kily-smith/Kily_Power/README.md

# Kily_PowerUnit
双向四开关同步整流Buck-Boost同步整流超级电容控制器

# 底部

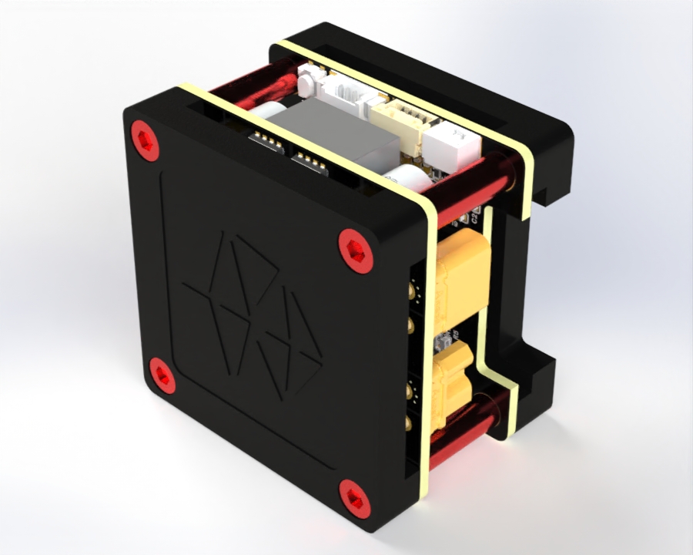
[picture p1: IMAGES/1.jpg]


# 顶部

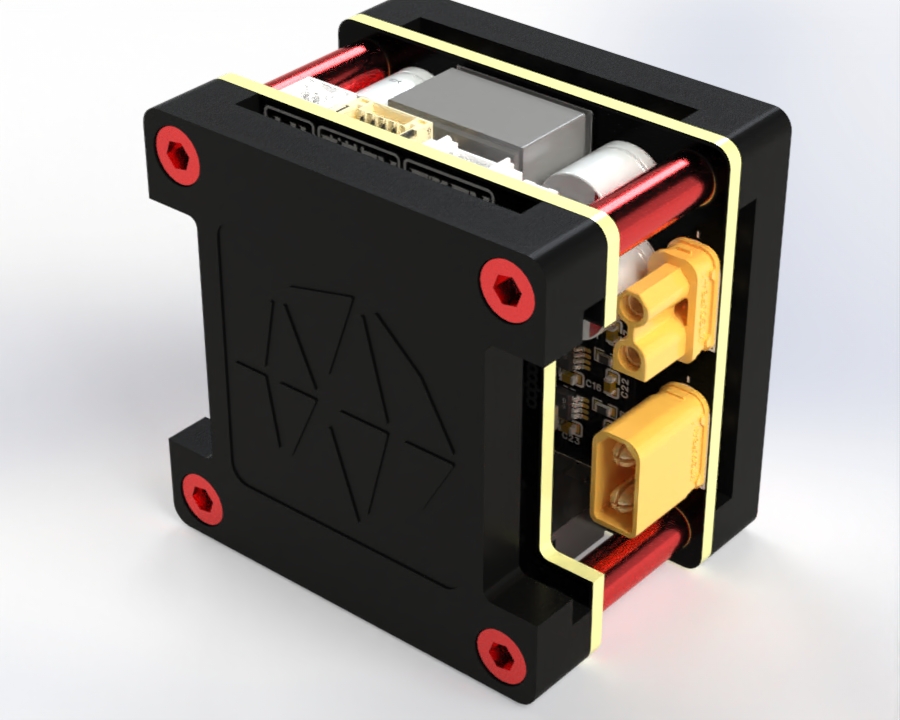
[picture p2: IMAGES/2.jpg]


# 功率板

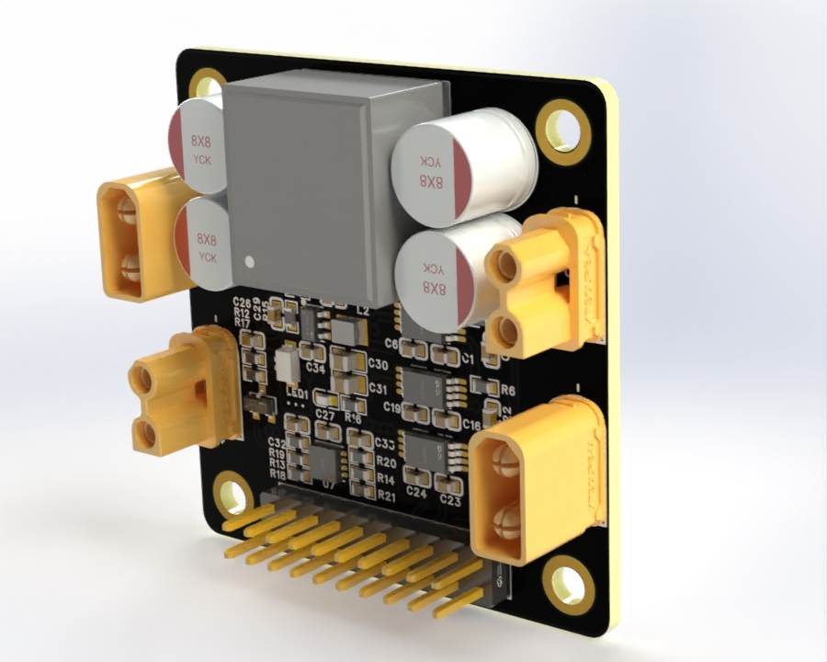
[picture p3: IMAGES/3.jpg]


注意：>>
