kily-smith/Kily_Power/3D_MODEL/3D_Kily_Contrl_45mm_V0.1_2025-03-08.png

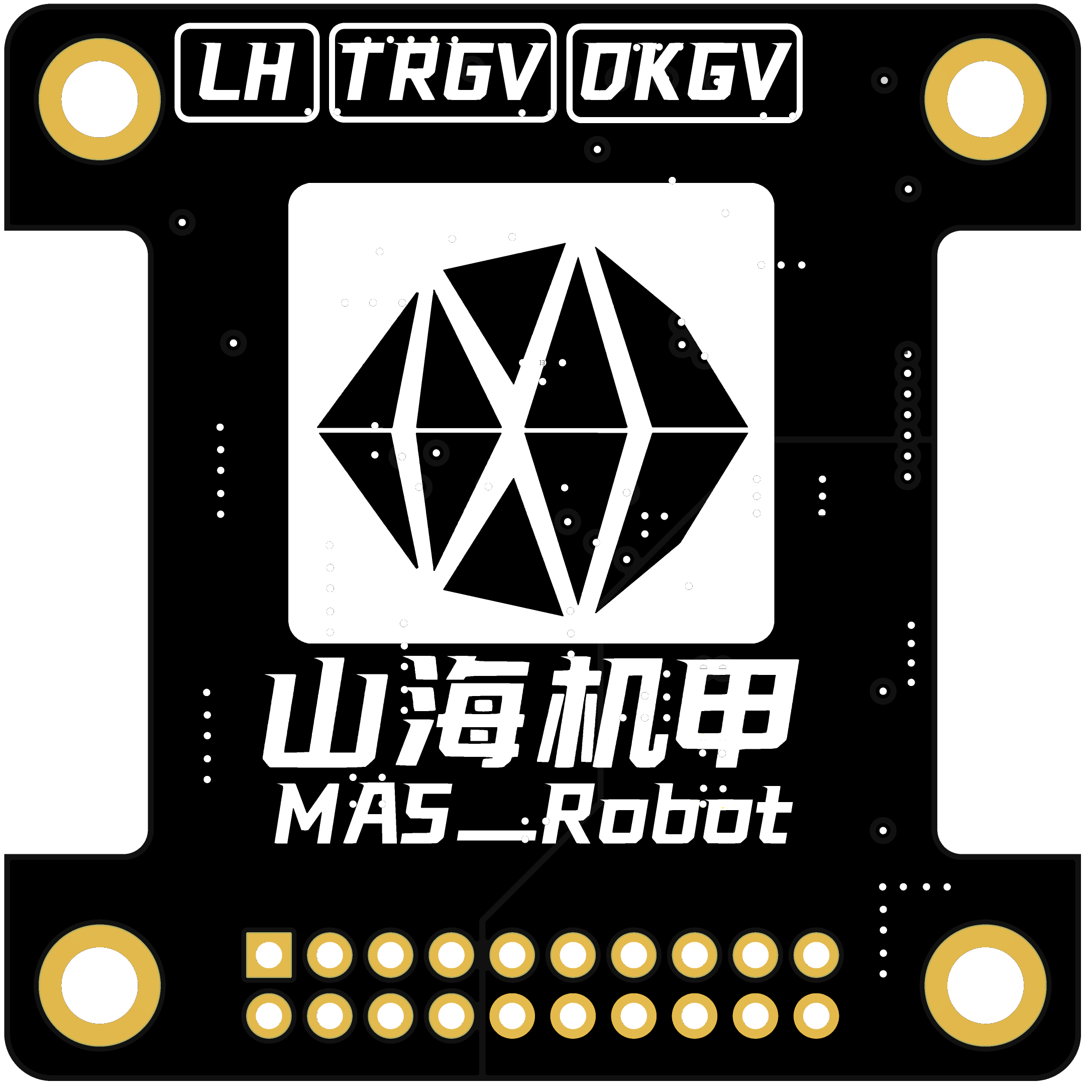
3D_MODEL/3D_Kily_Contrl_45mm_V0.1_2025-03-08.png
