kily-smith/Kily_Power/3D_MODEL/3D_Kily_Power_45mm_2025-03-08 (1).png

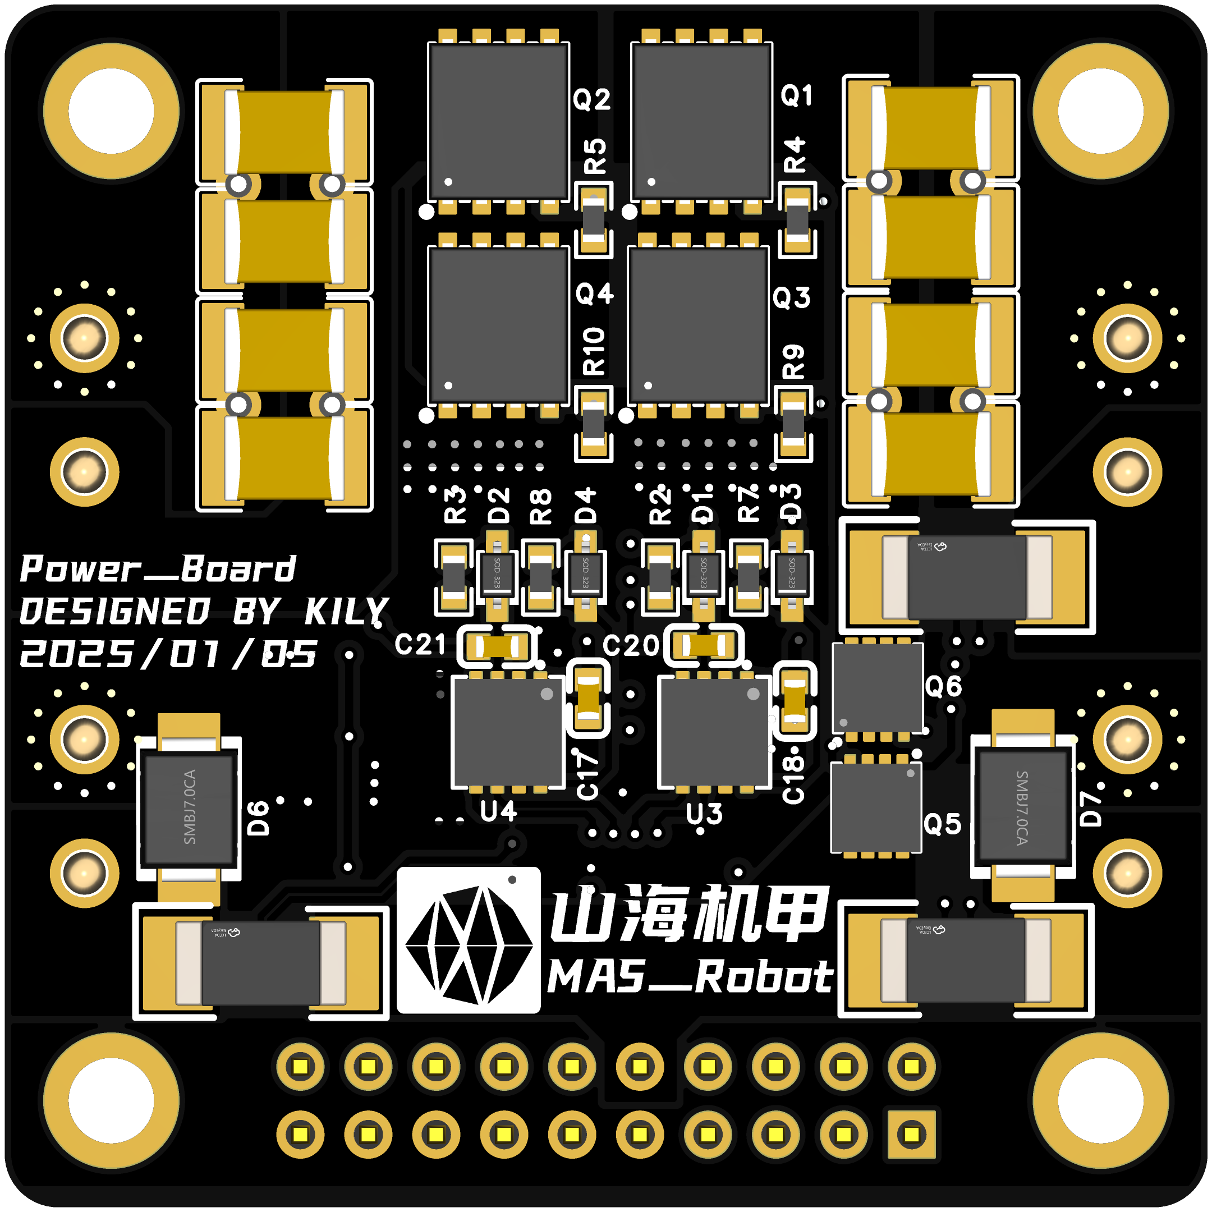
3D_MODEL/3D_Kily_Power_45mm_2025-03-08 (1).png
