kily-smith/Kily_Power/3D_MODEL/SuperCapUnit_MODEL/3D_PCB8_2_2025-03-09 (1).png

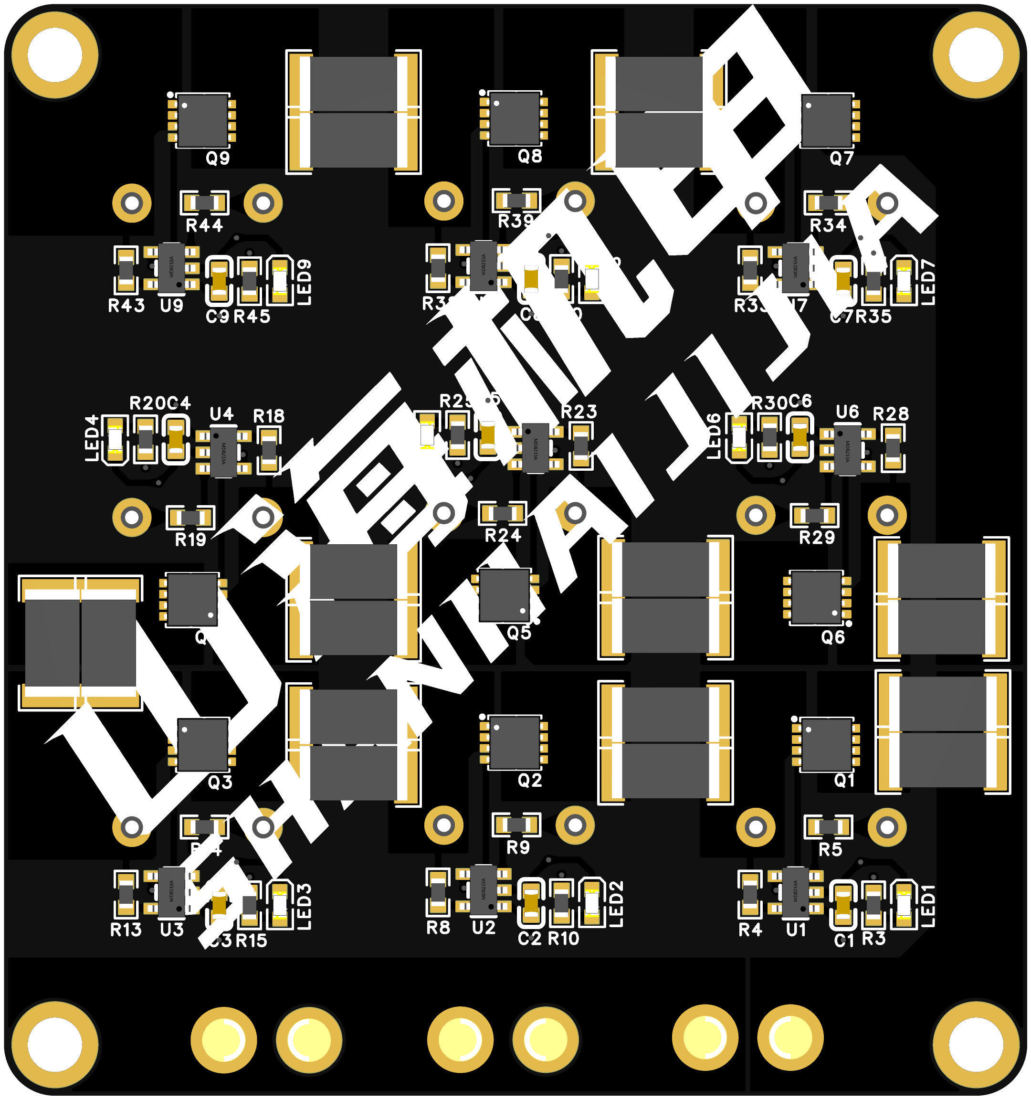
3D_MODEL/SuperCapUnit_MODEL/3D_PCB8_2_2025-03-09 (1).png
