kily-smith/Kily_Power/3D_MODEL/SuperCapUnit_MODEL/3D_PCB8_2_2025-03-09.png

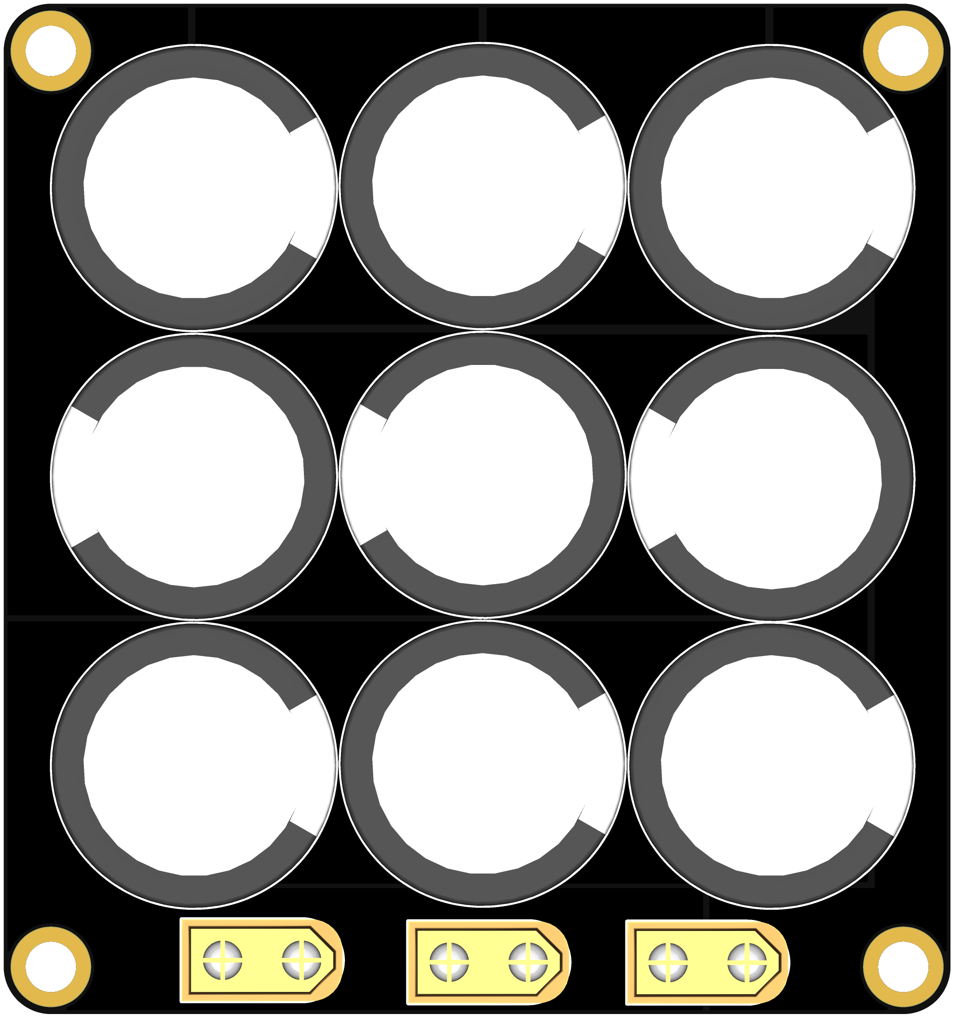
3D_MODEL/SuperCapUnit_MODEL/3D_PCB8_2_2025-03-09.png
