kily-smith/Kily_Power/IMAGES/3D_Kily_Contrl_45mm_2025-02-06.png

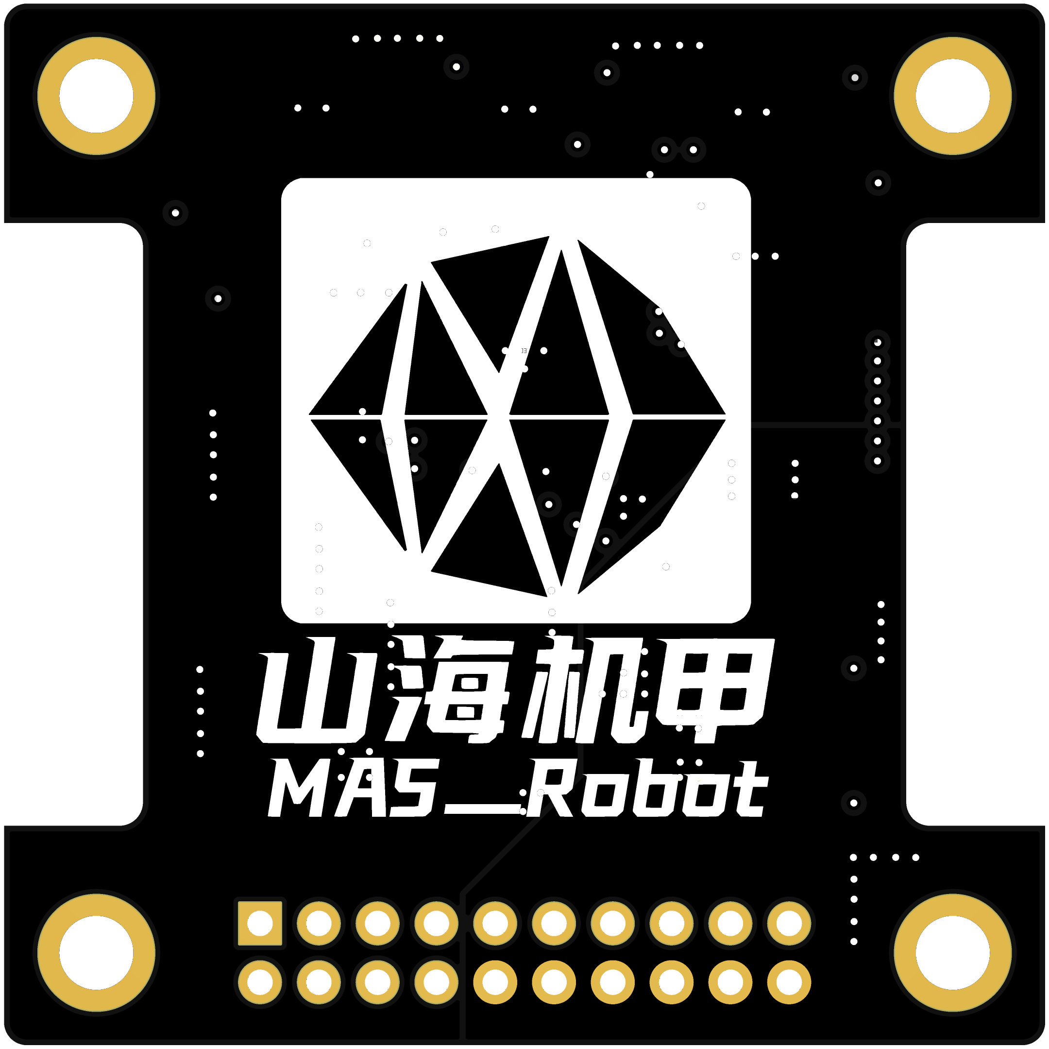
IMAGES/3D_Kily_Contrl_45mm_2025-02-06.png
