kily-smith/Kily_Power/IMAGES/image-20250205175824411.png

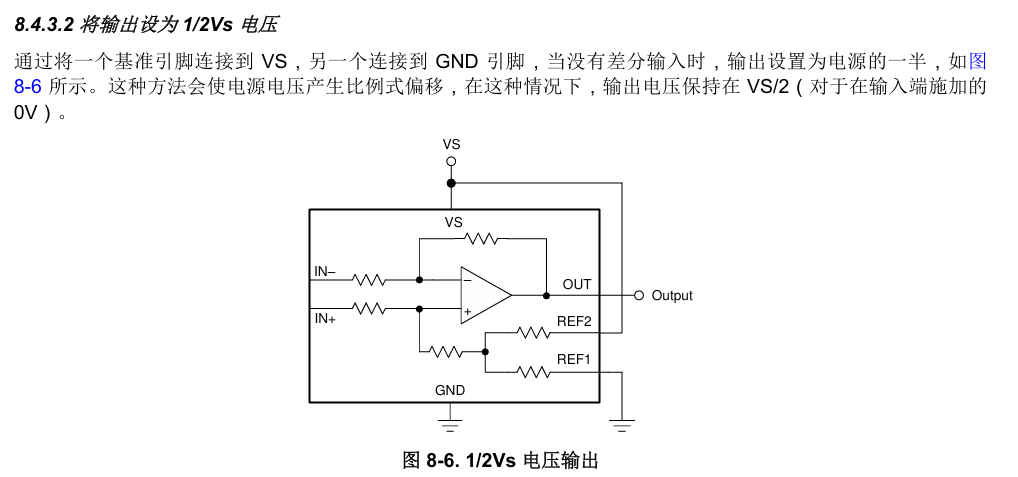
IMAGES/image-20250205175824411.png
