kily-smith/Kily_Power/3D_MODEL/STEP/【机加工件】cnc_顶板_D3.STEP

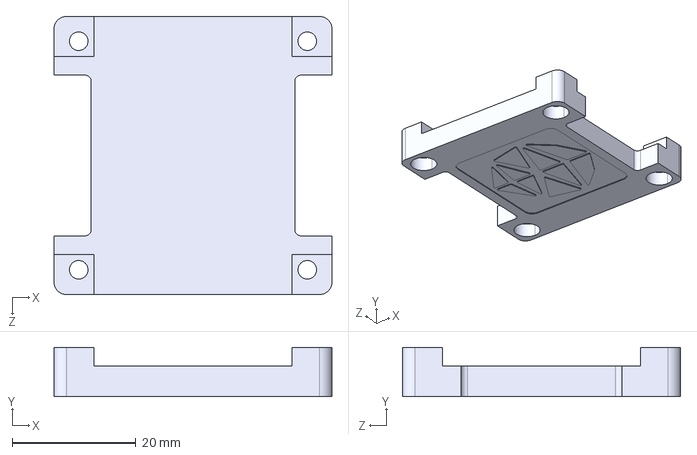
[picture p30: CAD file, 2025-03-08]
3D_MODEL/STEP/【机加工件】cnc_顶板_D3.STEP
45.0 x 8.00 x 45.0 mm
