kily-smith/Kily_Power/3D_MODEL/SuperCapUnit_MODEL/【机加工件】cnc_电容组顶底板_D2.5_带标模板.SLDPRT

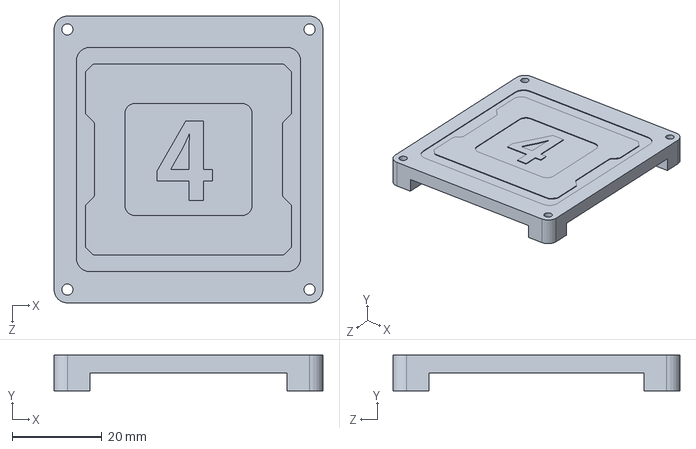
[picture p31: CAD file, 2025-04-09]
3D_MODEL/SuperCapUnit_MODEL/【机加工件】cnc_电容组顶底板_D2.5_带标模板.SLDPRT
60.0 x 8.00 x 64.0 mm
