kily-smith/Kily_Power/3D_MODEL/STEP/【机加工件】cnc_底板_D3.STEP.STEP

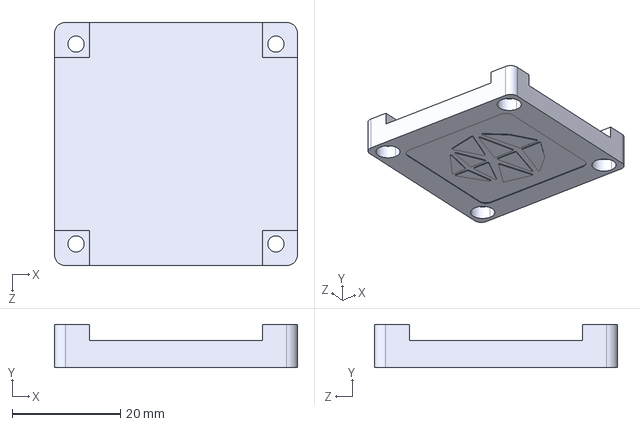
[picture p33: CAD file, 2025-03-08]
3D_MODEL/STEP/【机加工件】cnc_底板_D3.STEP.STEP
45.0 x 8.00 x 45.0 mm
