kily-smith/Kily_Power/3D_MODEL/SuperCapUnit_MODEL/嘉立创下单文件/【机加工件】cnc_电容组顶底板_D2.5_带队标.STEP

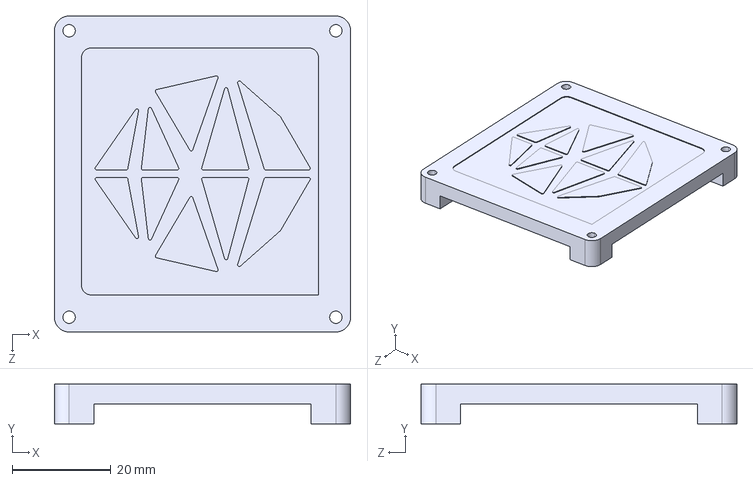
[picture p34: CAD file, 2025-04-07]
3D_MODEL/SuperCapUnit_MODEL/嘉立创下单文件/【机加工件】cnc_电容组顶底板_D2.5_带队标.STEP
60.0 x 8.00 x 64.0 mm
