kily-smith/Kily_Power/3D_MODEL/【标准件】M3-16+4单头螺柱.SLDPRT

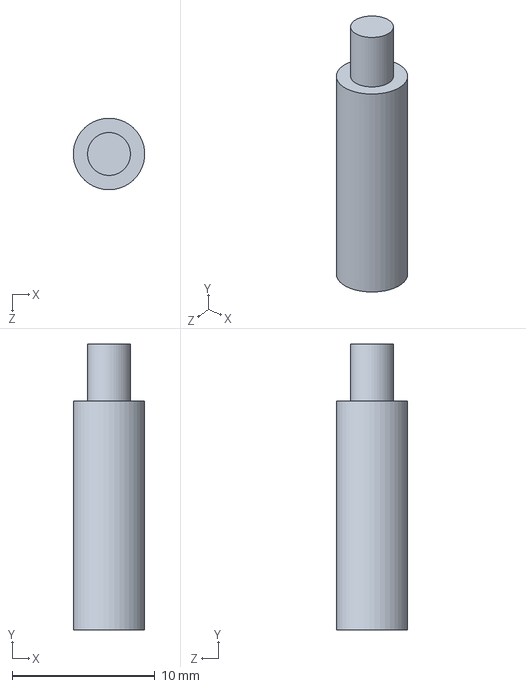
[picture p35: CAD file, 2025-04-07]
3D_MODEL/【标准件】M3-16+4单头螺柱.SLDPRT
4.99 x 20.0 x 5.00 mm
