kily-smith/Kily_Power/3D_MODEL/【标准件】M3-10内六角螺栓.SLDPRT

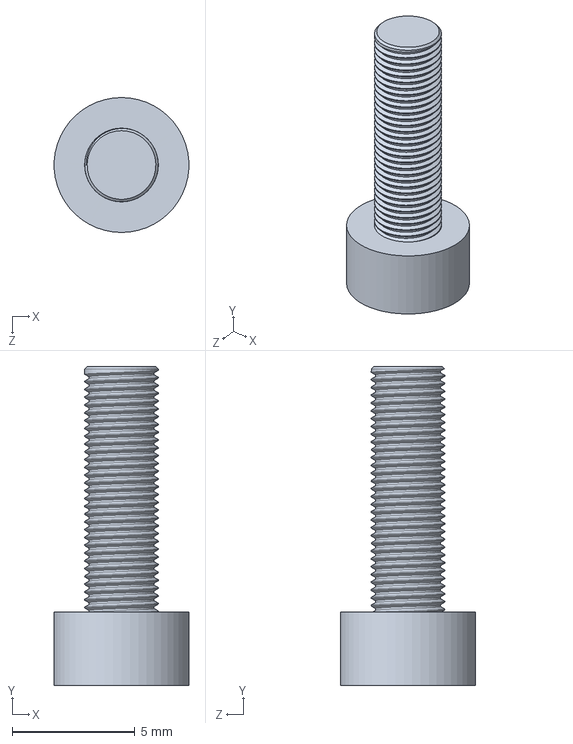
[picture p36: CAD file, 2025-04-07]
3D_MODEL/【标准件】M3-10内六角螺栓.SLDPRT
5.49 x 13.0 x 5.50 mm
