kily-smith/Kily_Power/3D_MODEL/【标准件】M3-6内六角螺栓.SLDPRT

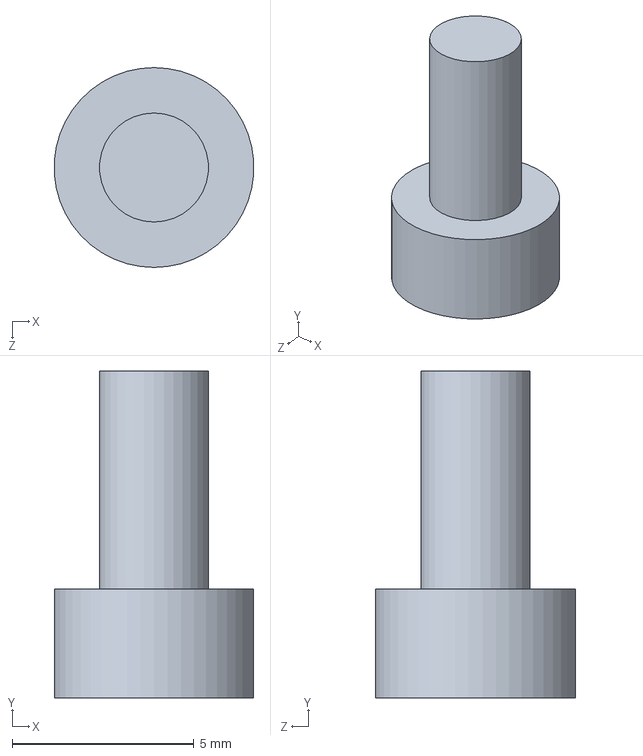
[picture p37: CAD file, 2025-04-07]
3D_MODEL/【标准件】M3-6内六角螺栓.SLDPRT
5.49 x 9.00 x 5.50 mm
