kily-smith/Kily_Power/(list of files, cad)

Other CAD files:
3D_MODEL/SuperCapUnit_MODEL/嘉立创下单文件/【机加工件】cnc_电容组顶底板_D2.5_带4号装甲板标.STEP.STEP
3D_MODEL/SuperCapUnit_MODEL/【机加工件】cnc_电容组顶底板_D3.SLDPRT
3D_MODEL/SuperCapUnit_MODEL/嘉立创下单/004.STEP
3D_MODEL/【机加工件】cnc_平板散热片_带R_D3.STEP
3D_MODEL/SuperCapUnit_MODEL/【机加工件】cnc_电容组顶底板_D2.5带logo.SLDPRT
3D_MODEL/SuperCapUnit_MODEL/嘉立创下单文件/【机加工件】cnc_电容组顶底板_D2.5_带7号装甲板标.STEP.STEP.STEP
3D_MODEL/【机加工件】cnc_顶板_D3带R标.STEP
3D_MODEL/SuperCapUnit_MODEL/嘉立创下单/【机加工件】cnc_电容组顶底板_D2.5_带R标.STEP
3D_MODEL/SuperCapUnit_MODEL/嘉立创下单文件/【机加工件】cnc_电容组顶底板_D2.5_带3号装甲板标.STEP.STEP
3D_MODEL/SuperCapUnit_MODEL/嘉立创下单文件/【机加工件】cnc_电容组顶底板_D2.5_带R标.STEP
3D_MODEL/SuperCapUnit_MODEL/嘉立创下单文件/【机加工件】cnc_电容组顶底板_D2.5_带1号装甲板标.STEP
3D_MODEL/【机加工件】cnc_顶板_D2.55M3.SLDPRT
3D_MODEL/SuperCapUnit_MODEL/嘉立创下单文件/【机加工件】cnc_电容组顶底板_D2.5_带5号装甲板标.STEP.STEP
3D_MODEL/SuperCapUnit_MODEL/嘉立创下单文件/【机加工件】cnc_电容组顶底板_D2.5_带2号装甲板标.STEP.STEP
3D_MODEL/【机加工件】cnc_平板散热片_带logo_m2.5.SLDPRT
