kily-smith/Kily_Power/HARDWARE/SCH_Kily_Contrl_45mm_V0.1_2025-03-09.pdf

# POWER

10k | Kily_PowerUnit_2025⁻01⁻28_17⁻55⁻04Kily_Contrl_45mm_V0.1.P1

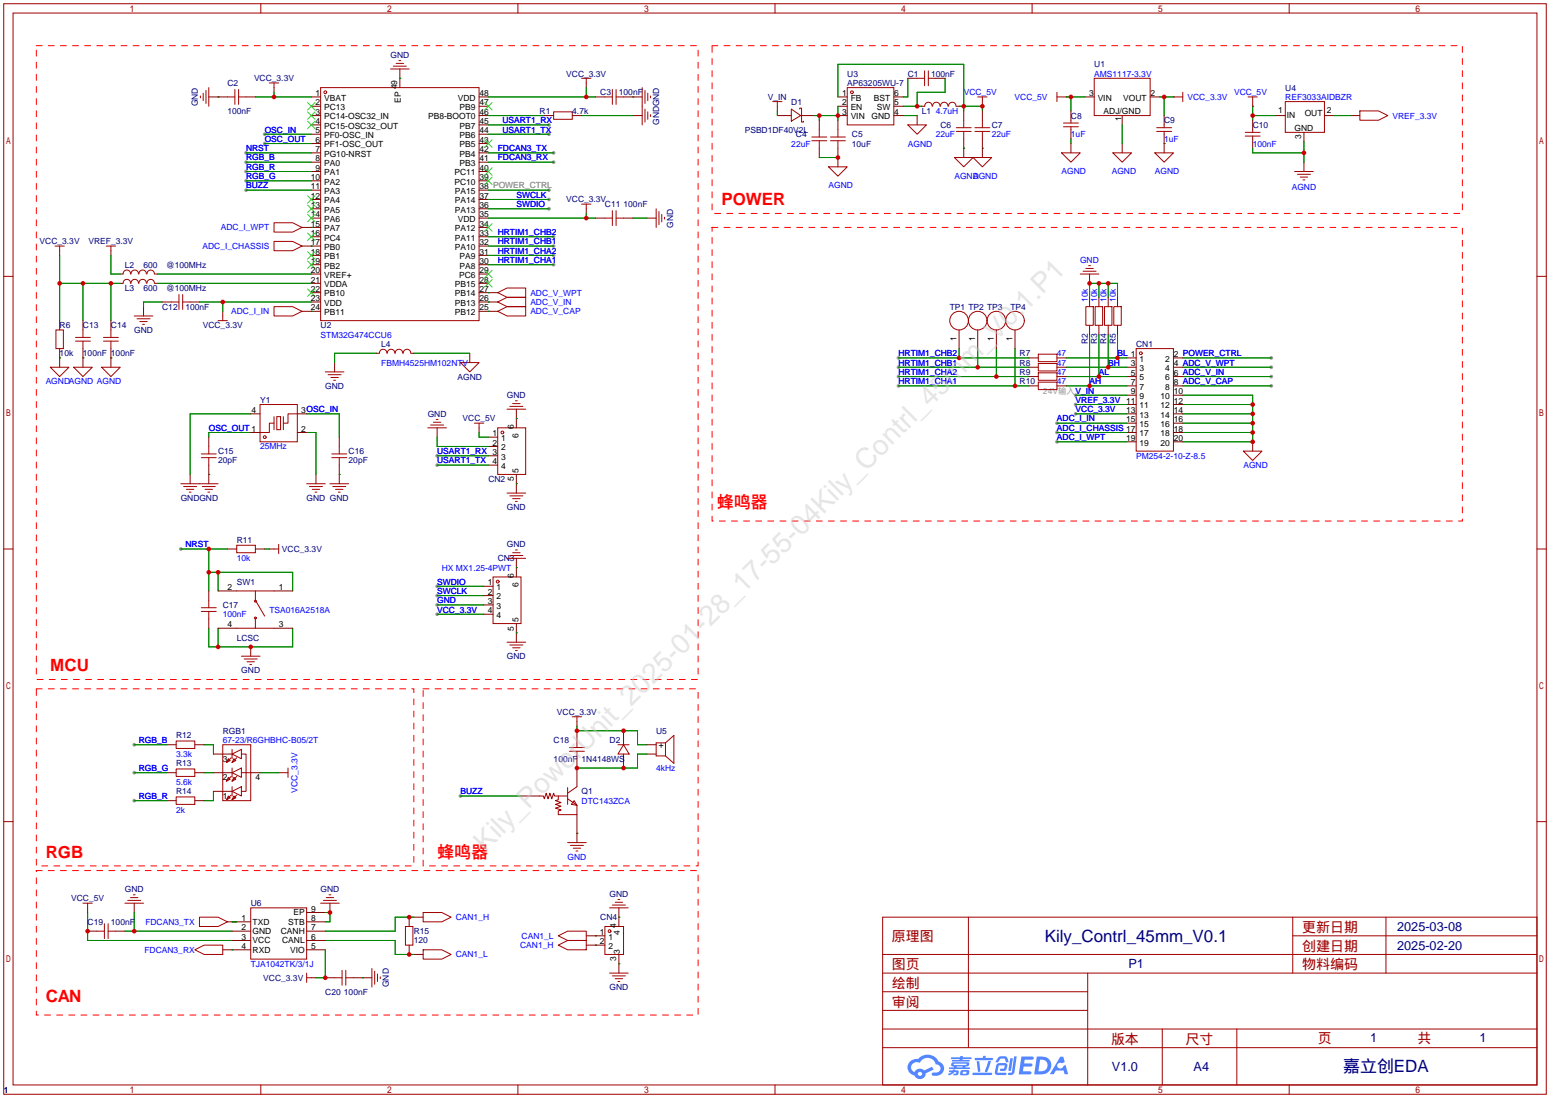
[picture p38: page 1]
