kily-smith/Kily_Power/HARDWARE/SCH_Kily_Contrl_45mm_2025-02-12.pdf

# POWER

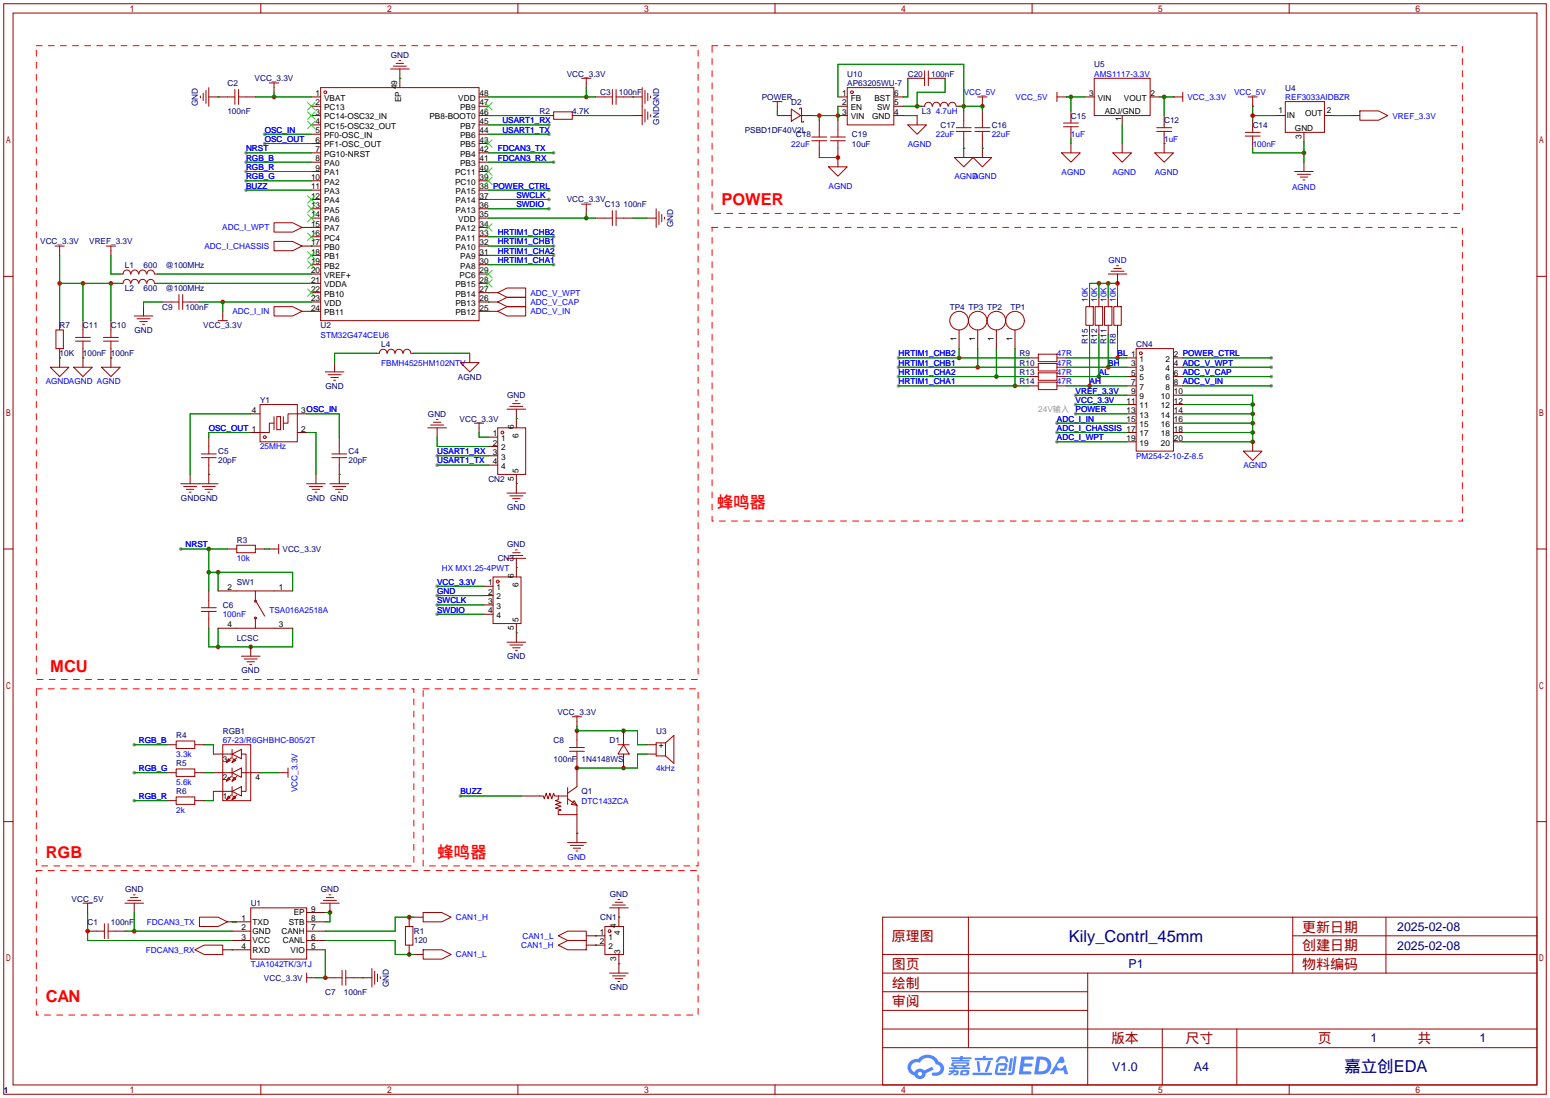
[picture p39: page 1]
