kily-smith/Kily_Power/HARDWARE/SCH_超级电容组（四层）V0.1_2025-03-11.pdf

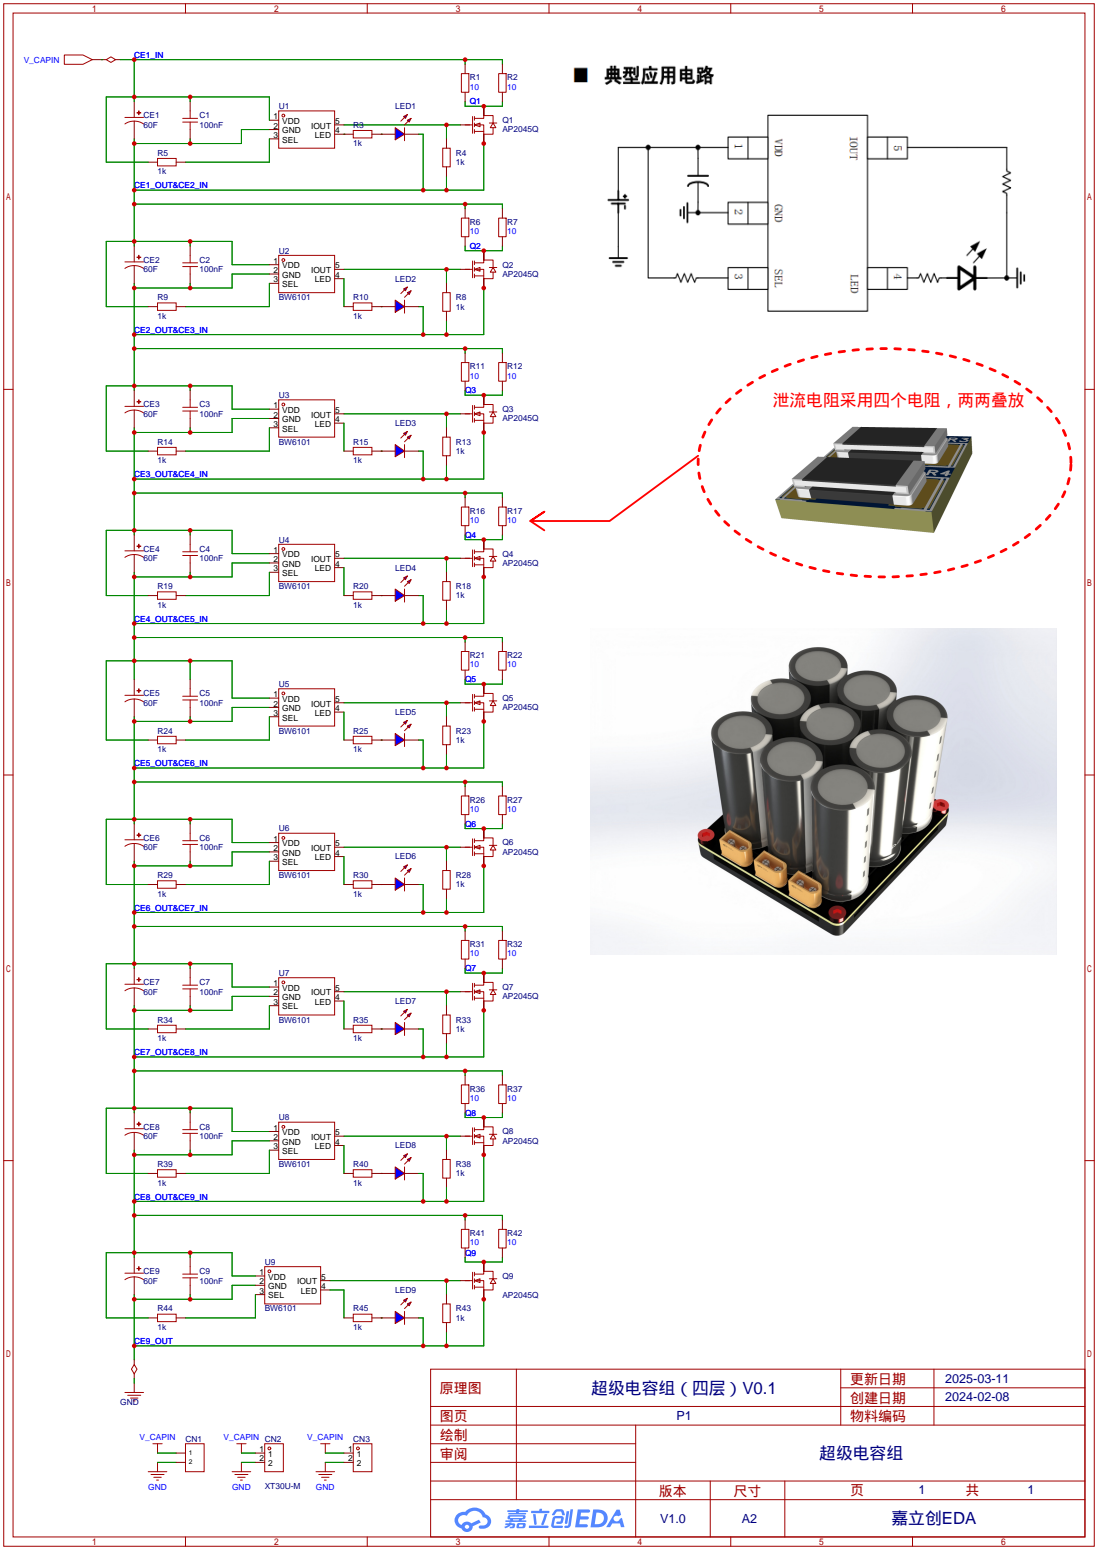
[picture p40: page 1]
