kily-smith/Kily_Power/HARDWARE/SCH_Kily_Power_45mm_2025-02-12.pdf

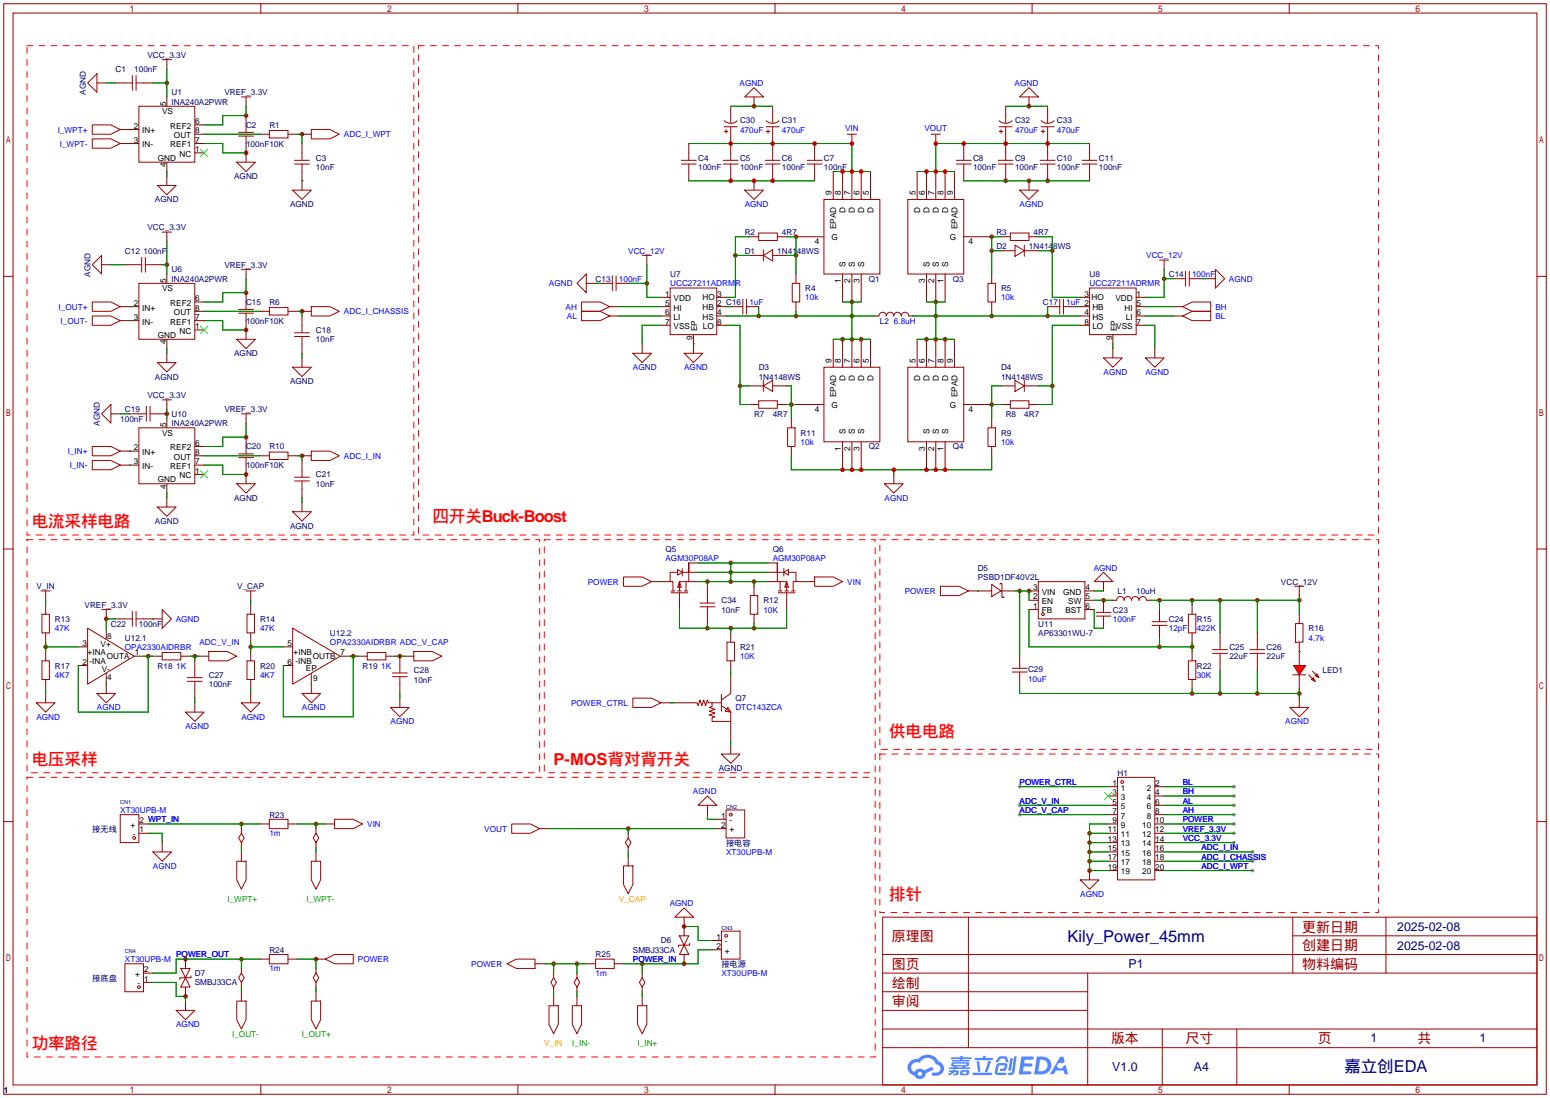
[picture p41: page 1]
