kily-smith/Kily_Power/SOFTWARE/PowerUnit_test/Core/Src/main.c

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
/* Includes ------------------------------------------------------------------*/
#include "main.h"
#include "adc.h"
#include "fdcan.h"
#include "fmac.h"
#include "hrtim.h"
#include "opamp.h"
#include "usart.h"
#include "gpio.h"

/* USER CODE BEGIN Includes */

#include <stdio.h>
#include "bsp_fdcan.h"

/* USER CODE END Includes */


void SystemClock_Config(void);
/* USER CODE BEGIN 0 */

char *str  = "USART_TEST";
uint8_t tx_data[8] = {0,1,2,3,4,5,6,7};
/* USER CODE END 0 */

/**
  * @brief  The application entry point.
  * @retval int
  */
int main(void)
{

  /* MCU Configuration--------------------------------------------------------*/

  /* Reset of all peripherals, Initializes the Flash interface and the Systick. */
  HAL_Init();

  /* Configure the system clock */
  SystemClock_Config();

  /* Initialize all configured peripherals */
  MX_GPIO_Init();
  MX_ADC1_Init();
  MX_FDCAN3_Init();
  MX_HRTIM1_Init();
  MX_ADC2_Init();
  MX_ADC3_Init();
  MX_ADC4_Init();
  MX_ADC5_Init();
  MX_FMAC_Init();
  MX_OPAMP1_Init();
  MX_OPAMP2_Init();
  MX_OPAMP3_Init();
  MX_OPAMP4_Init();
  MX_OPAMP5_Init();
  MX_OPAMP6_Init();
  MX_USART1_UART_Init();
  /* USER CODE BEGIN 2 */
	
	bsp_can_init();

  /* USER CODE END 2 */

  /* Infinite loop */
  /* USER CODE BEGIN WHILE */
  while (1)
  {


		fdcanx_send_data(&hfdcan3, 0x520, tx_data, 8);
		HAL_Delay(100);
		
		printf("%s\r\n",str);


    /* USER CODE END WHILE */

    /* USER CODE BEGIN 3 */
		
	HAL_GPIO_WritePin (RGB_G_GPIO_Port ,RGB_G_Pin ,GPIO_PIN_RESET);
	HAL_Delay (100);
	HAL_GPIO_WritePin (RGB_G_GPIO_Port ,RGB_G_Pin ,GPIO_PIN_SET);		
	HAL_Delay (100);
	HAL_GPIO_WritePin (RGB_B_GPIO_Port ,RGB_B_Pin ,GPIO_PIN_RESET);
	HAL_Delay (100);
	HAL_GPIO_WritePin (RGB_B_GPIO_Port ,RGB_B_Pin ,GPIO_PIN_SET);		
	HAL_Delay (100);
	HAL_GPIO_WritePin (RGB_R_GPIO_Port ,RGB_R_Pin ,GPIO_PIN_RESET);
	HAL_Delay (100);
	HAL_GPIO_WritePin (RGB_R_GPIO_Port ,RGB_R_Pin ,GPIO_PIN_SET);		
	HAL_Delay (100);
		
  }
  /* USER CODE END 3 */
}

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
/* USER CODE BEGIN 4 */

/*********************************************************
*
*重定义 fputc 函数
*
*********************************************************/

int fputc(int ch,FILE *f)
{
	HAL_UART_Transmit (&huart1 ,(uint8_t *)&ch,1,HAL_MAX_DELAY );
	return ch;
}


/* USER CODE END 4 */
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
