kily-smith/Kily_Power/SOFTWARE/PowerUnit_test/PowerUnit_test.ioc

Mcu.UserName=STM32G474CEUx
PA0.GPIO_Label=RGB_B
PA0.Signal=GPIO_Output
PA1.GPIO_Label=RGB_R
PA1.Signal=GPIO_Output
PA10.Signal=HRTIM1_CHB1
PA11.Signal=HRTIM1_CHB2
PA13.Signal=SYS_JTMS-SWDIO
PA14.Signal=SYS_JTCK-SWCLK
PA15.GPIO_Label=POWER_CTRL
PA15.Signal=GPIO_Output
PA2.GPIO_Label=RGB_G
PA2.Signal=GPIO_Output
PA3.GPIO_Label=BUZZ
PA3.Signal=GPIO_Output
PA7.Signal=OPAMP1_VINP
PA8.Signal=HRTIM1_CHA1
PA9.Signal=HRTIM1_CHA2
PB0.Signal=OPAMP2_VINP
PB11.Signal=OPAMP4_VINP
PB12.Signal=OPAMP6_VINP
PB13.Signal=OPAMP3_VINP
PB14.Signal=OPAMP5_VINP
PB3.Signal=FDCAN3_RX
PB4.Signal=FDCAN3_TX
PB6.Signal=USART1_TX
PB7.Signal=USART1_RX
PF0-OSC_IN.Signal=RCC_OSC_IN
PF1-OSC_OUT.Signal=RCC_OSC_OUT
