kily-smith/Kily_Power/(commit log)

2025-03-05 添加can收发测试
2025-03-06 Update 主控芯片选择
2025-03-08 蒸架 CNC散热片
    [【机加工件】cnc_底板_D3.STEP.STEP, 【机加工件】cnc_顶板_D3.STEP]
2025-03-08 添加 CNC散热片
2025-03-10 添加超级电容组
    [超级电容放电测试表.xlsx]
2025-04-07 给机械看的模型
    [【机加工件】cnc_底板_D3.STEP.STEP, 【机加工件】cnc_顶板_D3.STEP]
2025-04-09 添加GFerber文件
    [002.SLDPRT, 004.STEP, 1258952.STEP, 25.STEP, 【机加工件】cnc_电容组顶底板_D2.5.SLDPRT, 【机加工件】cnc_电容组顶底板_D2.5_带1号装甲板标.STEP, 【机加工件】cnc_电容组顶底板_D2.5_带2号装甲板标.STEP.STEP, 【机加工件】cnc_电容组顶底板_D2.5_带3号装甲板标.STEP.STEP]
